chaseunghyun02/battery-charger/T600_DAC650_BOM_v8.xlsx

T600 / DAC-650 충전기 컨트롤러 — 자재명세서 (BOM) v8
Control PCB(공용, FET 미실장) + FET 애드인 모듈(40A/100A, 2oz 동박, 헤더 스택 실장) + Sub PCB 구조 (아트웍 사양서 Rev.12 반영). ANODE/CATHODE 정정에 따라 FET 탭(CATHODE, 배터리측 개별넷)이 확인되어 공용 방열판에 FET별 개별 절연패드를 필수 적용한다. 보호 FET는 STP310N10F7, 40A 모듈은 FET1/FET2(2개소), 100A 모듈은 FET1~FET4(4개소) — 두 모듈은 상호 배타적 옵션이며 Control PCB는 완전 공용(전 규격 FET 미실장)이다. 배터리 출력 커넥터(PP45/SB120)는 고객이 별도로 선정/조달하며 본 BOM에서 제외. Sub PCB는 FND/버튼/상태LED 전용 전면판 보드로 라인업 전체에 공용. 외부 SMPS/케이스팬/인클로저는 별도 조달로 본 BOM에서 제외.
No. | 보드 | 구분 | 부품명 | Spec / 설명 | 제조사(예시) | 실장옵션 | 수량 | 단가(USD) | 금액(USD) | 비고
1 | Control PCB | 전원입력/보호단 | 입력단 릴레이 | 12V 코일, 20A/250VAC | Hongfa (HF115F/012-1HS3A) | 공통 | 1 | $1.50 | $1.50 | AC측 스위칭, 110V/220V 겸용
2 | Control PCB | 전원입력/보호단 | 역접속 보호 컨트롤러 (U1) | SOT23-6, 3.2~65V, 0.45µs 자동차단 | TI (LM74700QDBVRQ1) | 공통 | 1 | $0.47 | $0.47 | ANODE/GATE 공통넷을 헤더로 FET 모듈에 전달, CATHODE는 FET1만 대표 센싱(3.5절)
3 | Control PCB | 전원입력/보호단 | 충전펌프 캐패시터 (VCAP) | 0.1µF, X7R, 25V | - | 공통 | 1 | $0.02 | $0.02 | U1 VCAP-ANODE 간, 게이트 구동용
4 | Control PCB | 전원입력/보호단 | ANODE 입력 캐패시터 (CIN) | 22nF 이상, X7R | - | 공통 | 1 | $0.02 | $0.02 | U1 ANODE-GND 간 (데이터시트 권장)
5 | Control PCB | 전원입력/보호단 | AC 입력 터미널블록(2P) | 300V/20A급, 5.08mm 피치 | 예시: Degson | 공통 | 1 | $0.80 | $0.80 | 견적 필요(벤더 확정 전 추정가)
6 | Control PCB | 전원입력/보호단 | FET 모듈 인터페이스 소켓(Control PCB측, 암) | 2~3핀, 2.54mm 피치 | - | 공통 | 1 | $0.05 | $0.05 | ANODE+GATE(+선택적 키잉 핀), FET 모듈 헤더와 스택 결합. 배터리측 CATHODE 크림프는 본 헤더 미경유
7 | Control PCB | 보조전원 | AUX AC-DC 모듈 | 220V/110V In, 12V/3W Out | Hi-Link (HLK-PM12) | 공통 | 1 | $1.61 | $1.61 | 릴레이 앞단 상시 급전
8 | Control PCB | 보조전원 | 5V LDO 레귤레이터 | SOT-223, 12V→5V | 예시: AMS1117-5.0 | 공통 | 1 | $0.05 | $0.05 | MCU/FND/LED 5V 레일
9 | Control PCB | 보조전원 | LDO 입출력 커패시터 | 10µF, 16V, 0805 | - | 공통 | 2 | $0.02 | $0.04 | LDO 안정화용
10 | Control PCB | 컨트롤러 | MCU | TSSOP20, 8KB Flash | ST (STM8S003F3P6) | 공통 | 1 | $0.35 | $0.35 | FND/버튼/LED는 Sub PCB 헤더로 구동, ADC 2채널
11 | Control PCB | 릴레이 구동단 | 릴레이 구동 트랜지스터(Q1) | NPN, TO-92 | 예시: 2N2222 | 공통 | 1 | $0.05 | $0.05 | RELAY_DRV → 코일 저전위 스위칭
12 | Control PCB | 릴레이 구동단 | 베이스 저항(Rb) | 1kΩ, 1/4W | - | 공통 | 1 | $0.01 | $0.01 | -
13 | Control PCB | 릴레이 구동단 | 플라이백 다이오드(D1) | 1N4148 | - | 공통 | 1 | $0.02 | $0.02 | 코일 역기전력 클램프
14 | Control PCB | 센싱 | VBATT 분압저항 R5 | 100kΩ, 1%, 1/4W | - | 공통 | 1 | $0.02 | $0.02 | 최대 60V → ADC 약 3.2V
15 | Control PCB | 센싱 | VBATT 분압저항 R6 | 5.6kΩ, 1%, 1/4W | - | 공통 | 1 | $0.01 | $0.01 | -
16 | Control PCB | 센싱 | NTC 바이어스저항 R8 | 10kΩ, 1/4W | - | 공통 | 1 | $0.01 | $0.01 | -
17 | Control PCB | 센싱 | 온도센서(NTC1) | 10kΩ@25°C 서미스터 | - | 공통 | 1 | $0.10 | $0.10 | 충전기 온도 모니터링
18 | Control PCB | PCB/기타 | Sub PCB 인터페이스 헤더(Control PCB측) | 6~10핀, 2.54mm 피치 | - | 공통 | 1 | $0.08 | $0.08 | FND/버튼/GND/로직전원 신호
19 | Control PCB | PCB/기타 | Control PCB 원판 | 2층, 1oz 동박(FET 전류경로 없음, 로직/센싱 전용), 약 75×90mm | - | 공통 | 1 | $2.20 | $2.20 | 40A/100A 완전 공용 1종. FET 미실장으로 이전(약 80×120mm) 대비 소형화 및 동박 등급 하향(1-2oz→1oz)
20 | FET 모듈 | 전원입력/보호단 | 보호 MOSFET (FET1/FET2, 40A 모듈) | 100V, RDS_on 2.7mΩ, TO-220 | STMicroelectronics (STP310N10F7) | 공통 | 2 | $2.17 | $4.34 | 40A 모듈에 항상 실장. 40A/100A 모듈 공용 부품
21 | FET 모듈 | 전원입력/보호단 | 보호 MOSFET (FET3/FET4, 100A 모듈 전용) | 100V, RDS_on 2.7mΩ, TO-220 (FET1/FET2와 동일부품) | STMicroelectronics (STP310N10F7) | 100A DNP | 2 | $2.17 | $4.34 | 100A 모듈에만 추가 실장(총 4개소). 40A 모듈에는 없음
22 | FET 모듈 | 전원입력/보호단 | FET 절연패드 세트(TO-220용, FET1/FET2) | 실리콘/마이카 절연패드+부싱 | - | 공통 | 2 | $0.03 | $0.06 | CATHODE가 FET별 개별 넷이므로 필수(방열판 비절연 접촉 금지, 5.4절 정정 반영)
23 | FET 모듈 | 전원입력/보호단 | FET 절연패드 세트(TO-220용, FET3/FET4) | 실리콘/마이카 절연패드+부싱 | - | 100A DNP | 2 | $0.03 | $0.06 | 100A 모듈 전용 추가분
24 | FET 모듈 | 전원입력/보호단 | 크림프 러그+전선 세트(FET1/FET2용, 개별) | 8AWG, 양단 압착단자, 약 150mm | - | 공통 | 2 | $0.50 | $1.00 | CATHODE 개별 넷 — 모듈에서 배터리 출력 커넥터까지 직결(Control PCB 미경유, 3.4/3.5절)
25 | FET 모듈 | 전원입력/보호단 | 크림프 러그+전선 세트(FET3/FET4용, 개별) | 8AWG, 양단 압착단자, 약 150mm | - | 100A DNP | 2 | $0.50 | $1.00 | 100A 모듈 전용 추가, 배선 길이/게이지를 FET1과 매칭 필수(3.5절)
26 | FET 모듈 | PCB/기타 | FET 모듈 방열판 (40A용, 소형 콤형) | 약 25×20×15mm, Rth(s-a)≈20°C/W급, 범용 유통품, FET1/FET2 2개소 공용 1매 | 예시: LCSC 등 범용 유통(브랜드 비지정) | 40A전용 | 1 | $0.35 | $0.35 | FET별 개별 절연패드 필수(베어 접촉 금지), 프레임 그라운드와 절연·이격 필수. 열마진: 5.4절 참조
27 | FET 모듈 | PCB/기타 | FET 모듈 방열판 (100A용, 소형 콤형) | 약 50×20×15mm, Rth(s-a)≈15°C/W급, 범용 유통품, FET1~FET4 4개소 공용 1매 | 예시: LCSC 등 범용 유통(브랜드 비지정) | 100A DNP | 1 | $0.60 | $0.60 | FET별 개별 절연패드 필수(베어 접촉 금지), 프레임 그라운드와 절연·이격 필수. 열마진: 5.4절 참조
28 | FET 모듈 | PCB/기타 | FET 모듈 인터페이스 헤더(모듈측, 수) | 2~3핀, 2.54mm 피치 | - | 공통 | 1 | $0.03 | $0.03 | ANODE+GATE(+선택적 키잉), Control PCB측 소켓과 스택 결합
29 | FET 모듈 | PCB/기타 | FET 모듈 PCB - 40A (2oz 동박) | 2층, 2oz 동박, 약 35×30mm, FET1/FET2 실장 | - | 40A전용 | 1 | $0.80 | $0.80 | Control PCB와 완전 분리된 별도 원판. 트레이스 폭 7.4mm/위치(+20%마진, 3.3절)
30 | FET 모듈 | PCB/기타 | FET 모듈 PCB - 100A (2oz 동박) | 2층, 2oz 동박, 약 70×30mm, FET1~FET4 실장 | - | 100A DNP | 1 | $1.20 | $1.20 | Control PCB와 완전 분리된 별도 원판, 40A 모듈과 상호 배타적 옵션. 트레이스 폭 10.0mm/위치(+20%마진, 3.3절)
31 | Sub PCB | 표시부 | 택트 버튼(SW1) | 6x6mm 표면형 | - | 공통 | 1 | $0.05 | $0.05 | 내부 풀업 사용, 외부 저항 불필요
32 | Sub PCB | 표시부 | 상태 LED | 5mm 또는 SMD, 저전력 | - | 공통 | 2 | $0.05 | $0.10 | LED1 상태표시, LED2 충전중
33 | Sub PCB | 표시부 | LED 전류제한저항(R3,R4) | 330Ω, 1/4W | - | 공통 | 2 | $0.01 | $0.02 | -
34 | Sub PCB | 표시부 | FND (3자리 7-세그먼트) | 0.56", 공통캐소드 | 예시 규격 | 공통 | 1 | $0.50 | $0.50 | Control PCB MCU가 헤더 통해 멀티플렉스 구동
35 | Sub PCB | 표시부 | Sub PCB 인터페이스 헤더(Sub PCB측) | 6~10핀, 2.54mm 피치 | - | 공통 | 1 | $0.08 | $0.08 | Control PCB측 헤더와 리본/직결
36 | Sub PCB | PCB/기타 | Sub PCB 원판 | 2층, 1oz 동박, 소형(케이스 전면 크기에 맞춤) | - | 공통 | 1 | $1.00 | $1.00 | 견적 필요
40A 구성 부품단가 합계 (공통 + 40A전용) |  |  |  |  |  |  |  |  | $15.74
100A 구성 부품단가 합계 (공통 + 100A DNP) |  |  |  |  |  |  |  |  | $21.79
주1: 단가는 LCSC/Digikey/Mouser 등 공개 유통가 또는 유사부품 참고 추정치이며, 실제 조달가는 물량/벤더 견적에 따라 달라질 수 있음. 외부 SMPS, 인클로저, 케이블/하네스(위 크림프 세트 제외), 조립비는 본 BOM에서 제외. 배터리 출력 커넥터(패널마운트)는 고객 별도 조달 품목으로 본 BOM에서 제외.
주2: v8부터 보호 FET 및 방열판을 Control PCB에서 분리해 별도의 FET 애드인 모듈(40A/100A, 2oz 동박)로 구성한다. ANODE/CATHODE 정정(ANODE=SMPS측 공통넷, CATHODE=배터리측 개별넷)에 따라 FET 탭이 개별 넷임이 확인되어, v7까지의 방열판 베어 접촉 방식을 철회하고 FET별 개별 절연패드를 필수 적용했다(단가 반영). 40A 모듈(FET1/2, 약 35×30mm)과 100A 모듈(FET1~4, 약 70×30mm)은 Control PCB(약 75×90mm, 완전 공용, 1oz 동박)에 핀헤더로 스택 실장되며 상호 배타적 옵션이다. 상세 근거는 T600_아트웍_사양서 Rev.12 참조.
