chaseunghyun02/battery-charger/DAC 650 조립회로도 스켄.pdf

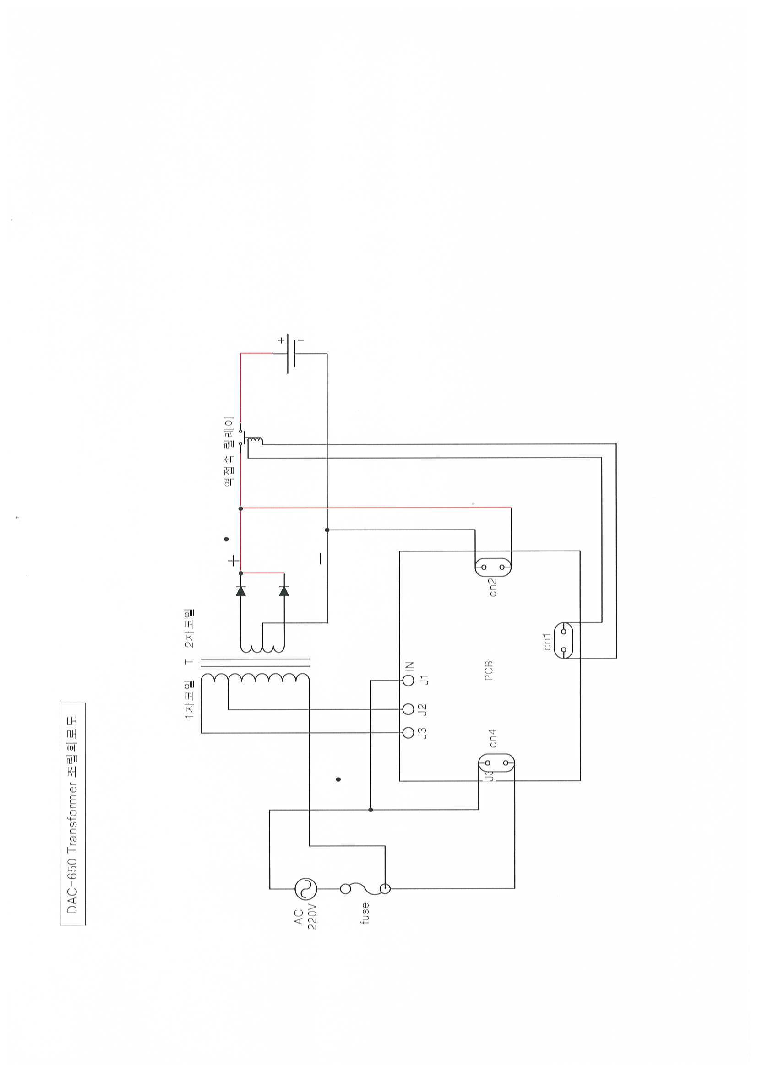
[picture p15: page 1]
