chaseunghyun02/battery-charger/FET보드_회로도.pdf

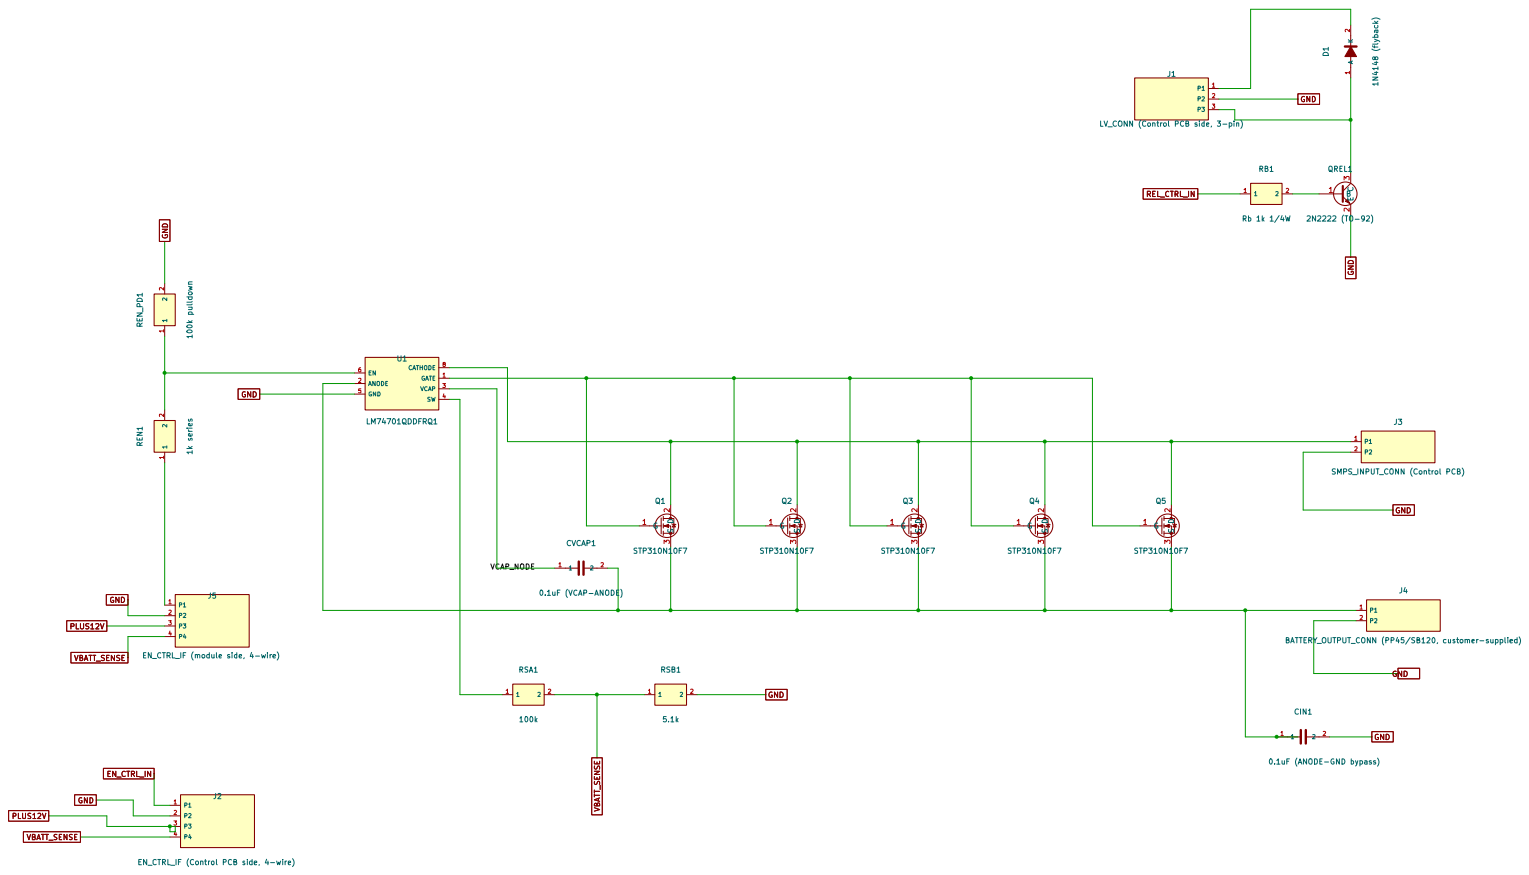
[picture p17: page 1]
