chaseunghyun02/battery-charger/FET_module_r18.pdf

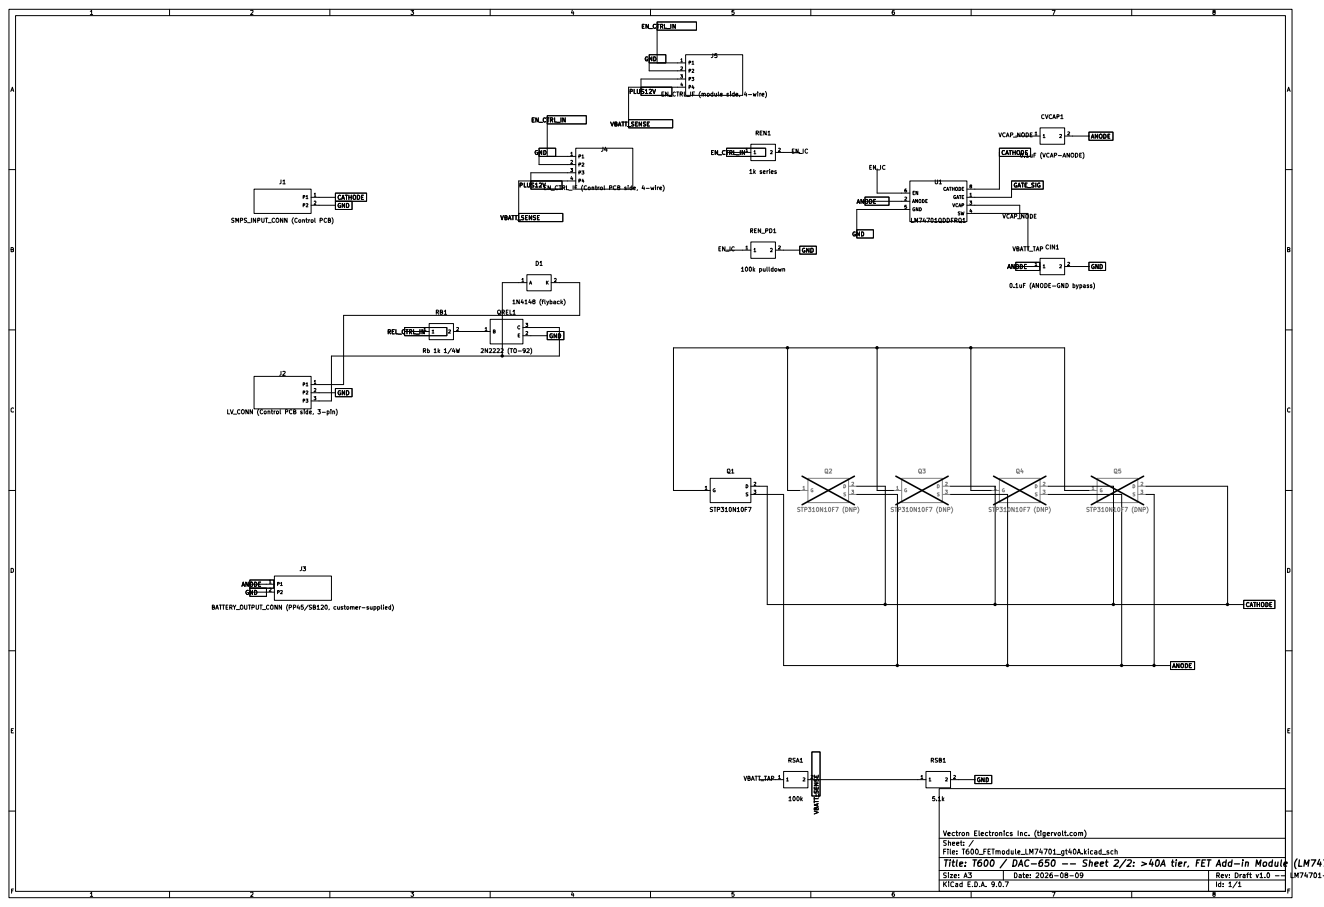
[picture p18: page 1]
