chaseunghyun02/battery-charger/DAC 650 PCB 회로도.pdf

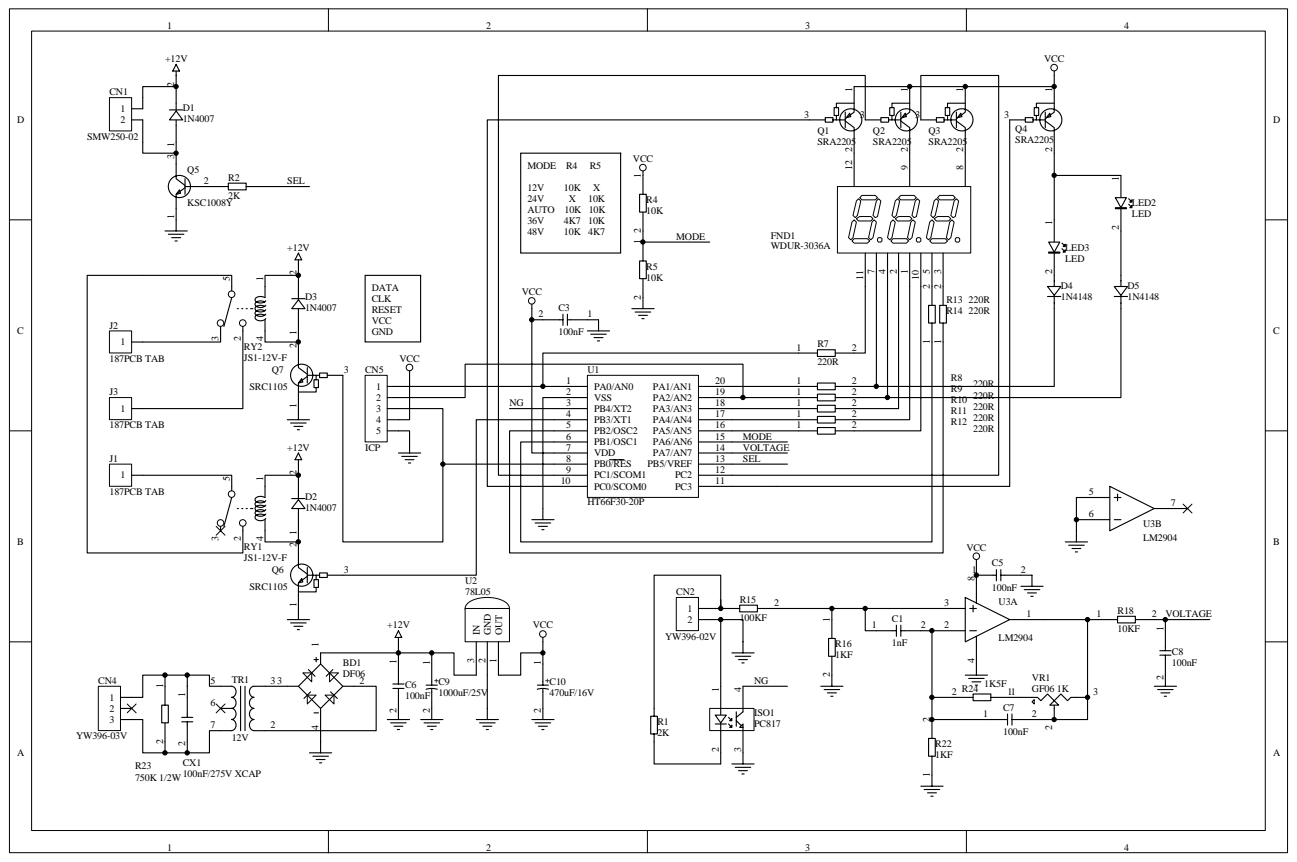
[picture p19: page 1]

NG | VSS 2
