chaseunghyun02/battery-charger/(list of files, drawings)

Other design files:
POWER.pcb
SENSOR_V1.DSN
