chaseunghyun02/battery-charger/(commit log)

2026-08-06 relay changed
    [POWER.sch]
2026-08-06 Add files via upload
    schematic to pdf file convert
2026-08-11 reference sch
    [ATS9606_P_PTC_Rev2-240408.sch]
2026-08-11 connect add
    [POWER.sch]
2026-08-11 add connector
2026-08-11 chaned 8월 11일
2026-08-11 changed 8월 11일
    [POWER.sch]
2026-08-13 ART PREPARE
    [POWER.sch]
2026-08-18 ready file
    [POWER.pcb, POWER.sch]
2026-09-06 smps on off control
    [SENSOR_V1.DSN]
